FireInstallations/SpaceOrienter/README.md

# SpaceOrienter

Our universe is gigant and even our nightsky can be confusing big and messy if you are not an expert.
It's even if you try to show heavenly bodies to other people. 
Or maybe you don't know where to find is what.

The SpaceOrienter project is a small tool and a solution for all problems of this kind.
SpaceOrienter? What is that and how to use it?
The SpaceOrienter startet as "JugendForscht"-project back in 2016 and basicly is a small device, build of an ArduIno(Leonardo), a magneticfied sensor and an acceleration sensor. It points with a weak laser into the sky direkly to the body that was searched for. At the moment it uses for calculating the positions of the bodys an external computer and mainly the crossplatform app will be uploaded here.
But nevertheless, even without the device is the app not useless as it answers many questions about the nightsky and what is waiting to find up there.

Pease Note: the app only supports the german langue at the moment, but multilingual support is planed for the near future!

--- descriptions how to use following soon ---

If you want to use ephemeris you have to place WMM.COF to the working folder of the app (may change in future). More informations at: [WMM.COF](https://github.com/FireInstallations/SpaceOrienter/wiki/WMM.COF) and [portable mode](https://github.com/FireInstallations/SpaceOrienter/wiki/Portable-Mode).

If you like to code for the App, Lazarus IDE would be recommend and Eye Candy Controls is required (just install it to Lazarus). More informations how to build the app will be found [here](https://github.com/FireInstallations/SpaceOrienter/wiki/Build-the-App).

If you want to help this project read [How to help](https://github.com/FireInstallations/SpaceOrienter/wiki/How-to-Help).

***

Ephemeris calculation is taken from [PlanEph](https://sourceforge.net/projects/planeph/) libiry and translated to pascal. So I don't own anything about this part of the project. As well as the [Synapse Units](http://www.ararat.cz/synapse/doku.php/download). Have a look at this fantastic projects!
