FireInstallations/SpaceOrienter/(threads)

Thread 7 (2018-10-10):

reset config button

FireInstall, 2018-10-10:
Resetting the configurations doesn't make all the switches return into their default state, since the Options are not loaded from file again anymore.
