FireInstallations/SpaceOrienter/(commit log)

2017-06-09 Readme-de created
2019-11-05 Finally we can send and get data from the arduino! But the whole optionssystem has changed too!
    On the other hanfdside, the connection to the arduino is as buggy as the ephemerides.
    Fixed some Errors and repainted the configurationform.
2019-11-05 Fixed Lon / Lad (Lamda and Phi are gone, hopefully for ever) Fixed calculation of positions of the stars
    Removed unessesary Springbegin form Options
    Portablemode should work now!
    missing Options in LoadOptions will get know a default value instat of pushing an Error
2019-11-05 Options should be saved now correctly, even if some options where missed Start GetData-timer only if we are conneced All option finally in own form (added big button on config page, so you don't have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
2019-11-05 Added Exel/TwedgeWersion (old WILL NOT GET ANY UPDATES) and ArduIno code (will get Updates -> put App files in own dir
    [Fixsterne.xlsx]
2019-11-05 short rename and .gitignore will ignore double *.COF now
    [Fixsterne.xlsx]
2019-11-05 Hotkeys should work now! Please note: the input edit field on the config form doesn't work yet, just use the nearby button. Changed how Keys are saved (now in word form instead of clear code), so the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
2019-11-05 Fixes Bug in IauSofa files coursed of double used names since pascal is not case sensitive; credit goes to Raul! (Since it doesn't saved correctly last commit here is another try)
    Added option to not choose any Hotkey at all
2019-11-05 Fixed Bug in LoadOptions: Loading Hotkeys doesn't destroys them anymore Fixed Bux in LoadOptions: flipping the Autoconnect switch doesn't break synaser anymore Removed old Menue Items Portablemode wi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
2019-11-05 Added Eph katein names created Secound Mainform, please get confused Cleaned calculate timer up Places list should work now in all OS Bilefeld doesn't exist
2019-11-05 After ManuValue mode was switched back off it will respect "ruheposition" now ad reset all manu changes Renamed the Manu floatSpinEdits, so they fit to the other names Finially found a way to dispaly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
2019-11-05 Fist steps of 2.nd thread. However there is still so much work before it's running again. Feel free to help, some information about multithreading can be found here: wiki.freepascal.org/Multithreaded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
2019-11-05 ArduIno code got updated
2019-11-05 Auto ON_AutoComMode is finally usefull the whole connection to the ArduIno is now in it's own thread
2019-11-05 Legends never die, but sometimes they retire. So basicly the old main form is gone. Moreover the calculation page got tripled in hope it will be more clearly now what happens.
2019-11-05 cleaned up ArduIno code
2019-11-05 Added compass at mainpage and rotated azimuth, so north is up by now. Minor Fixed in ArduIno code
    [SpaceOrienter_ArduIno.ino]
2019-11-05 better handeling of incomming values by the ArduIndo minor fix in ArduInocode for movement size
    [SpaceOrienter_ArduIno.ino]
2019-11-05 made arduino faster and more accurate
2019-11-05 Added DemoMode. Points after 5 minutes with no imput at a save angle.
    Large parts have been rewritten for ArduIno, should be way cleaner now!
